afch/DDS-AD9910-Arduino-Shield/README.md

# DDS-AD9910-Arduino-Shield
DDS (Direct Digital Synthesis) Analog Devices AD9910 Arduino Shield by GRA &amp; AFCH

[HARDWARE Version 2.x:](https://github.com/afch/DDS-AD9910-Arduino-Shield/blob/master/README_HW2.md)  
[HARDWARE Version 3.x:](https://github.com/afch/DDS-AD9910-Arduino-Shield/blob/master/README_HW3.md)
