afch/DDS-AD9910-Arduino-Shield/Firmware Compiled (.HEX File)/HW2.x/Select Proper Arduino(Mega 2560).png

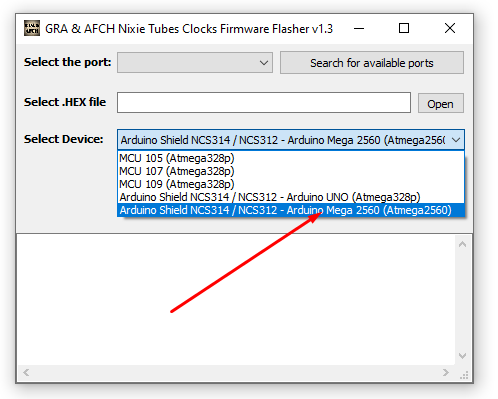
Firmware Compiled (.HEX File)/HW2.x/Select Proper Arduino(Mega 2560).png
