afch/DDS-AD9910-Arduino-Shield/Firmware Compiled (.HEX File)/HW2.x/Thank you Console Screenshot.png

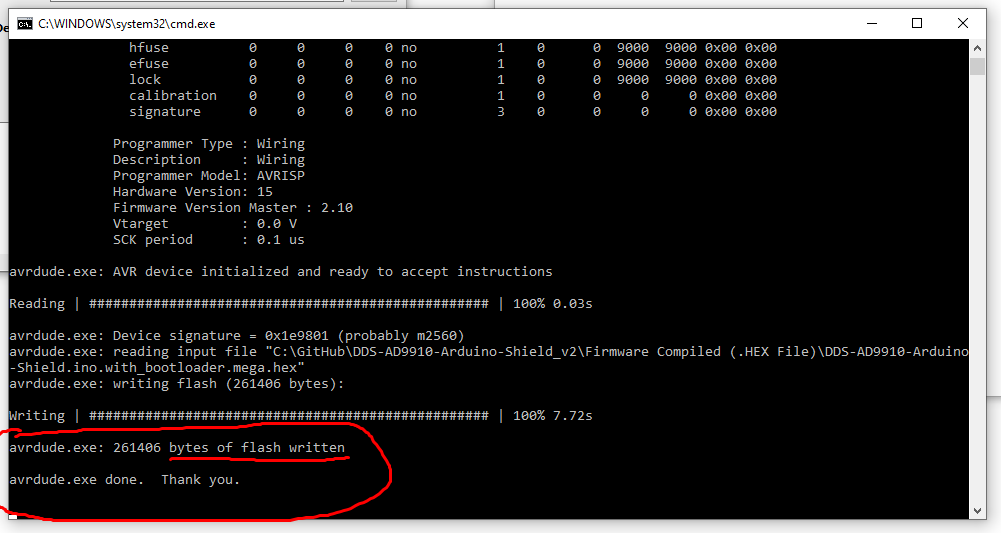
Firmware Compiled (.HEX File)/HW2.x/Thank you Console Screenshot.png
