afch/DDS-AD9910-Arduino-Shield/Firmware Source (.INO File)/HW3.x/DDS-AD9910-Arduino-Shield_HW3.x/ad9910.cpp

/****************************************************************************
 *   OFICIAL WEB-SITE:  https://gra-afch.com/product-category/rf-units/     *
 ****************************************************************************                                      
 *
 * AD9910 - DDS Power Supply 3.3V - 1.8V
 * Internal PLL up to 1.52 GHz, REF CLK Oscillator 5 - 60Mhz (PLL Enabled)
 * For More pure spectrum Recomendeted exteral oscillator 1 - 1.5 GHz
 * For signal without harmonics and the spur use an RF transformer  
 * ADT2-1T + LPF 7rd order Range: 0.4-450MHZ
 * ADT2-1T-1P + LPF 7rd order Range: 8-600MHZ
 * WBC2-1TLB + LPF 7rd order Range: 0.1(-4dB)-600MHZ(-7dB)
 * CX2147 + LPF 7rd order Range: 0.02(-3dB)-365(-3dB)/ or 0.01(-8dB)-480(-8dB)
 * Fout up 600 Mhz 
 * 17.06.2020
 * Author Grisha Anofriev e-mail: grisha.anofriev@gmail.com
******************************************************************************/

#include <Float64.h>
#define DEFAULT_STEP_VALUE 1000

#include "ad9910.h"
//#include "menuclk.h"
#include "main.h"

#include <math.h>
#include <float.h>
#include <Arduino.h>
int hspi1=0;

uint32_t DAC_Current;

uint8_t strBuffer[9];//={129, 165, 15, 255};

uint32_t FTW;
uint32_t *jlob;

extern uint32_t Ref_Clk;

void HAL_SPI_Transmit(int *blank, uint8_t *strBuffer, int nums, int pause)
{
  for (int i=0;i<nums; i++)
  {
    SPI.transfer(*(strBuffer+i));
  }
}

void HAL_Delay (int del)
{
  delayMicroseconds(del);
}
/******************************************************************************
 * HAL to Arduino
******************************************************************************/

void HAL_GPIO_WritePin (int port, int pin, int mode)
{
  digitalWrite(pin, mode);
}

/******************************************************************************
 * Init GPIO for DDS
******************************************************************************/
void DDS_GPIO_Init(void)
{
   pinMode(DDS_SPI_SCLK_PIN, OUTPUT);
   pinMode(DDS_SPI_SDIO_PIN, OUTPUT);
   pinMode(DDS_SPI_SDO_PIN, INPUT);
   pinMode(DDS_SPI_CS_PIN, OUTPUT);
   pinMode(DDS_IO_UPDATE_PIN, OUTPUT);
   pinMode(DDS_IO_RESET_PIN, OUTPUT);
   pinMode(DDS_MASTER_RESET_PIN, OUTPUT);
   pinMode(DDS_PROFILE_0_PIN, OUTPUT);
   pinMode(DDS_PROFILE_1_PIN, OUTPUT);
   pinMode(DDS_PROFILE_2_PIN, OUTPUT);
   pinMode(DDS_OSK_PIN, OUTPUT);
   pinMode(DDS_TxENABLE_PIN, OUTPUT);
   pinMode(DDS_F0_PIN, OUTPUT);
   pinMode(DDS_F1_PIN, OUTPUT);
   pinMode(DDS_DRHOLD_PIN, OUTPUT);
   pinMode(DDS_PWR_DWN_PIN, OUTPUT);
   pinMode(DDS_DRCTL_PIN, OUTPUT);
   
   pinMode(DDS_DROVER, INPUT);
   pinMode(DDS_SYNC_CLK, INPUT);
   pinMode(DDS_RAM_SWP_OVR, INPUT);
   pinMode(DDS_PLL_LOCK, INPUT);
   pinMode(DDS_PDCLK_PIN, INPUT);

  /*Configure GPIO pin Output Level */
  HAL_Delay(50);
  HAL_GPIO_WritePin(DDS_IO_UPDATE_GPIO_PORT, DDS_IO_UPDATE_PIN, GPIO_PIN_RESET);
  HAL_Delay(50);
	HAL_GPIO_WritePin(DDS_MASTER_RESET_GPIO_PORT, DDS_MASTER_RESET_PIN, GPIO_PIN_RESET);
  HAL_Delay(50);
	HAL_GPIO_WritePin(DDS_SPI_CS_GPIO_PORT, DDS_SPI_CS_PIN, GPIO_PIN_RESET);
  HAL_Delay(50);
	HAL_GPIO_WritePin(DDS_OSK_GPIO_PORT, DDS_OSK_PIN, GPIO_PIN_RESET);                     // OSK = 0
  HAL_Delay(50);
	HAL_GPIO_WritePin(DDS_PROFILE_0_GPIO_PORT, DDS_PROFILE_0_PIN, GPIO_PIN_RESET);
	HAL_GPIO_WritePin(DDS_PROFILE_1_GPIO_PORT, DDS_PROFILE_1_PIN, GPIO_PIN_RESET);
	HAL_GPIO_WritePin(DDS_PROFILE_2_GPIO_PORT, DDS_PROFILE_2_PIN, GPIO_PIN_RESET);

  HAL_GPIO_WritePin(DDS_PROFILE_2_GPIO_PORT, DDS_DRHOLD_PIN, GPIO_PIN_RESET);
  HAL_GPIO_WritePin(DDS_PROFILE_2_GPIO_PORT, DDS_DRCTL_PIN, GPIO_PIN_RESET);
  HAL_GPIO_WritePin(DDS_PROFILE_2_GPIO_PORT, DDS_PWR_DWN_PIN, GPIO_PIN_RESET);
  HAL_Delay(50);
}

/******************************************************************************
 * Init SPI, 8bit, Master
 * MODE 3, MSB, 
******************************************************************************/
void DDS_SPI_Init(void)
{
  SPI.begin(); //
  SPI.setDataMode (SPI_MODE0); 
  SPI.setClockDivider(SPI_CLOCK_DIV8); //16MHZ/8=2MHZ
  SPI.setBitOrder(MSBFIRST);
}


/*****************************************************************************************
   Update - data updates from memory
*****************************************************************************************/ 
void DDS_UPDATE(void)
{
	// Required - data updates from memory
   #if DBG==1
   Serial.println("***DDS_UPDATE****");
   #endif
	 HAL_Delay(10);
	 HAL_GPIO_WritePin(DDS_IO_UPDATE_GPIO_PORT, DDS_IO_UPDATE_PIN, GPIO_PIN_RESET); // IO_UPDATE = 0
	 HAL_Delay(10);
	 HAL_GPIO_WritePin(DDS_IO_UPDATE_GPIO_PORT, DDS_IO_UPDATE_PIN, GPIO_PIN_SET); // IO_UPDATE = 1
	 HAL_Delay(10);
	 HAL_GPIO_WritePin(DDS_IO_UPDATE_GPIO_PORT, DDS_IO_UPDATE_PIN, GPIO_PIN_RESET); // IO_UPDATE = 0
	 HAL_Delay(10);
}
 

/*****************************************************************************************
   F_OUT - Set Frequency in HZ 
   Num_Prof - Single Tone Mode 0..7
   Amplitude_dB - amplitude in dB from 0 to -84 (only negative values)
*****************************************************************************************/
void DDS_Fout (uint32_t *F_OUT, int16_t Amplitude_dB, uint8_t Num_Prof)
{
   uint32_t RealDDSCoreClock=CalcRealDDSCoreClockFromOffset();
   //FTW = ((uint32_t)(4294967296.0 *((float)*F_OUT / (float)DDS_Core_Clock)));
   //FTW = round(4294967296.0 *((float)*F_OUT / ((float)DDS_Core_Clock-ClockOffset))); // закомментировано 27.05.2020

   // значение FTW должно быть 4294967296 
    float64_t f64F_OUT=f64(*F_OUT);
    float64_t f64CoreClock=f64(RealDDSCoreClock);
    float64_t TwoPower32=f64(4294967295UL);
    float64_t f64FTW;
    //float64_t Offset=f64(ClockOffset);
    //CoreClock=f64_sub(CoreClock, Offset);
    f64FTW=f64_div(TwoPower32, f64CoreClock);
    f64FTW=f64_mul(f64FTW, f64F_OUT);
   //FTW = 4294967296 * (*F_OUT / (float)tmpCoreClock);
   bool a;
   uint_fast8_t softfloat_roundingMode;
   softfloat_roundingMode=softfloat_round_near_maxMag;
   FTW=f64_to_ui32(f64FTW, softfloat_roundingMode, a);
   jlob = & FTW;
   
   #if DBG==1
   Serial.print(F("*F_OUT="));
   Serial.println(*F_OUT); 
   Serial.print(F("DDS_Core_Clock="));
   Serial.println(DDS_Core_Clock); 
   Serial.print(F("FTW="));
   Serial.println(FTW); 
   #endif
   
   HAL_GPIO_WritePin(DDS_SPI_CS_GPIO_PORT, DDS_SPI_CS_PIN, GPIO_PIN_RESET); 	 
	 strBuffer[0] = Num_Prof; // Single_Tone_Profile_#;

   //ASF  - Amplitude 14bit 0...16127
	 strBuffer[1] =  (uint16_t)powf(10,(Amplitude_dB+84.288)/20.0) >> 8;     
	 strBuffer[2] =  (uint16_t)powf(10,(Amplitude_dB+84.288)/20.0);         
	 strBuffer[3] = 0x00;
	 strBuffer[4] = 0x00;

	 strBuffer[5] = *(((uint8_t*)jlob)+ 3);
	 strBuffer[6] = *(((uint8_t*)jlob)+ 2);
	 strBuffer[7] = *(((uint8_t*)jlob)+ 1);
	 strBuffer[8] = *(((uint8_t*)jlob));

   HAL_SPI_Transmit(&hspi1, (uint8_t*)strBuffer, 9, 1000);
	 HAL_GPIO_WritePin(DDS_SPI_CS_GPIO_PORT, DDS_SPI_CS_PIN, GPIO_PIN_SET);
	 
	 DDS_UPDATE(); 
  
   int Prof=Num_Prof;
   Prof=Prof-14; // address of 0 profile: 0x0E

   //Serial.print("Prof=");
   //Serial.println(Prof);
   
   if (bitRead(Prof, 0)==1) HAL_GPIO_WritePin(DDS_PROFILE_0_GPIO_PORT, DDS_PROFILE_0_PIN, GPIO_PIN_SET);
    else HAL_GPIO_WritePin(DDS_PROFILE_0_GPIO_PORT, DDS_PROFILE_0_PIN, GPIO_PIN_RESET);
   if (bitRead(Prof, 1)==1) HAL_GPIO_WritePin(DDS_PROFILE_1_GPIO_PORT, DDS_PROFILE_1_PIN, GPIO_PIN_SET);
    else HAL_GPIO_WritePin(DDS_PROFILE_1_GPIO_PORT, DDS_PROFILE_1_PIN, GPIO_PIN_RESET);
   if (bitRead(Prof, 2)==1) HAL_GPIO_WritePin(DDS_PROFILE_2_GPIO_PORT, DDS_PROFILE_2_PIN, GPIO_PIN_SET);
    else HAL_GPIO_WritePin(DDS_PROFILE_2_GPIO_PORT, DDS_PROFILE_2_PIN, GPIO_PIN_RESET);

   DDS_UPDATE(); 
   //while (1);
}	


/*****************************************************************************************
   PrepRegistersToSaveWaveForm - Setup control registers to load wave forms into DDS RAM only for AD9910
 * Step_Rate - the value of M for the register Step_Rate, for the desired sampling rate from RAM (based on uS)
*****************************************************************************************/
void PrepRegistersToSaveWaveForm (uint64_t Step_Rate, uint16_t Step)
{
  // Config RAM Playback ***  
  strBuffer[0] = RAM_Profile_0; // Address reg profile 0
  strBuffer[1] = 0x00; // open
  strBuffer[2] = highByte((uint16_t)Step_Rate);  // RAM address Step Rate [15:8]  0x03;
  strBuffer[3] = lowByte((uint16_t)Step_Rate); //0xFA;  // Step Rate [7:0] ///0x0F   0xE8;

  Step=Step-1;  //расчитваем последнюю ячейку памяти под хранение все сгенерированых данных (отнимаем 1 так как ядреса начитнаются с 0)
  Step=Step<<6; //значимые биты начинаются только с 6ой позиции (см датащит)
   
  strBuffer[4] = highByte(Step); //0xF9;  // End RAM address [9:2] bits in register 15:8 bit 0x1F 1024   (0xC0 + 0xF9) 0.....999 = 1000
  strBuffer[5] = lowByte(Step); //0xC0;  // End RAM address [1:0] bits in register 7:6 bit  0xC0 

  // Serial.print("highByte((uint16_t)Step_Rate)=");
  // Serial.println(highByte((uint16_t)Step_Rate));

  // Serial.print("lowByte((uint16_t)Step_Rate)=");
  // Serial.println(lowByte((uint16_t)Step_Rate));

  // Serial.print("highByte(Step)=");
  // Serial.println(highByte(Step));

  // Serial.print("lowByte(Step)=");
  // Serial.println(lowByte(Step));

   
  strBuffer[6] = 0x00;  // Start RAM address [9:2] bits in register 15:8 bit
  strBuffer[7] = 0x00;  // Start RAM address [1:0] bits in register 7:6 bit
    
  strBuffer[8] =  Continuous_recirculate; // b100 - Continuous recerculate   No_dwell_high |
     
  HAL_GPIO_WritePin(DDS_SPI_CS_GPIO_PORT, DDS_SPI_CS_PIN, GPIO_PIN_RESET);
  HAL_SPI_Transmit(&hspi1, (uint8_t*)strBuffer, 9, 1000);
  HAL_GPIO_WritePin(DDS_SPI_CS_GPIO_PORT, DDS_SPI_CS_PIN, GPIO_PIN_SET);
   
  DDS_UPDATE(); 
  
  //*** Select Profile 0 
  HAL_GPIO_WritePin(DDS_PROFILE_0_GPIO_PORT, DDS_PROFILE_0_PIN, GPIO_PIN_RESET);
  HAL_GPIO_WritePin(DDS_PROFILE_1_GPIO_PORT, DDS_PROFILE_1_PIN, GPIO_PIN_RESET);
  HAL_GPIO_WritePin(DDS_PROFILE_2_GPIO_PORT, DDS_PROFILE_2_PIN, GPIO_PIN_RESET);  
  
  DDS_UPDATE(); 
}

/************************************************************************************************************
 * Функция находит и взвращает такое значение STEP и StepRate при котором значение StepRate было бы целым числом, но при этом значение STEP не превысило бы значение 1000
 * входные параметры это: указатетль на переменную STEP, по адресу этого указателя будет возвращено новое значение STEP, 
 * указатетль на переменную StepRate, по адресу этого указателя будет возвращено новое значение StepRate, 
 * F_mod - частота модуляции
 ************************************************************************************************************/
void calcBestStepRate(uint16_t *Step, uint64_t *Step_Rate, uint32_t F_mod)
{
  double T_Step;
  double fStep_Rate;

  uint32_t RealDDSCoreClock=CalcRealDDSCoreClockFromOffset();
  
  T_Step = 1.0/(F_mod * *Step); // necessary time step
  fStep_Rate = (T_Step * (float)RealDDSCoreClock)/4; // the value of M for the register Step_Rate, for the desired sampling rate from RAM

  *Step_Rate=ceil(fStep_Rate);
 
  *Step=(1.0/((*Step_Rate*4)/(float)RealDDSCoreClock))/F_mod;
}

/*****************************************************************************************
   SaveAM_WavesToRAM - calculate and store AM waves to RAM
   Input data:
   * F_carrier - frequency carrier Hz
   * F_mod - amplitude modulations Hz, 10Hz Min, 100kHz Max
   * Depth - depth modulation      0-100%
   * Amplitude_dB - отрицательное значение амплитуды в dBm (кроме случая когда DAC Current = HI)
*****************************************************************************************/ 
void SaveAMWavesToRAM(uint32_t F_carrier, uint32_t F_mod, uint32_t AM_DEPH, int16_t Amplitude_dB)
{
  #if DBG==1
  Serial.println(F("****SaveAMWavesToRAM***"));
  Serial.print("F_carrier=");
  Serial.println(F_carrier);
  Serial.print("F_mod=");
  Serial.println(F_mod);
  Serial.print("AM_DEPH=");
  Serial.println(AM_DEPH);
  #endif
  
  #define TWO_POWER_32 4294967296.0 //2^32
  //#define MAX_AMPLITUDE_VALUE 16383

  uint16_t MaxAmplitudeValue=(uint16_t)powf(10,(Amplitude_dB+84.288)/20.0);
  
  uint64_t Step_Rate;
  uint16_t Step;
  uint16_t n;
  double Deg;
  double Rad;
  double Sin=0;
  double DegIncrement; //=360.0/Step;
  uint32_t Amplitude_AM=0;
  uint32_t FTW_AM=0;
  uint8_t aFTW_AM_8_bit[4];

  Step=DEFAULT_STEP_VALUE;
  Step_Rate=0;

  calcBestStepRate(&Step, &Step_Rate, F_mod);
  #if DBG==1
  Serial.print(F("Step Rate="));
  Serial.println((uint32_t)(Step_Rate));
  Serial.print(F("Step="));
  Serial.println((uint32_t)(Step));
  #endif
  
  PrepRegistersToSaveWaveForm(Step_Rate, Step);

  DegIncrement=360.0/Step;
    
  //*************************************************************************
  Deg = 0; // start set deg
  HAL_GPIO_WritePin(DDS_SPI_CS_GPIO_PORT, DDS_SPI_CS_PIN, GPIO_PIN_RESET);
  uint8_t MemAdr=RAM_Start_Word;
  HAL_SPI_Transmit(&hspi1, &MemAdr, 1, 1000);
  
  for (n = 0; n < Step; n++)
    {
     //Rad = Deg * 0.01745; // conversion from degrees to radians RAD=DEG*Pi/180
     Rad = Deg * PI/180.0; 
     Sin = sin(Rad); // Get Sinus
     Amplitude_AM = MaxAmplitudeValue - (((MaxAmplitudeValue * (1 + Sin)) / 2) * (AM_DEPH/100.0)); 
     #if DBG==1
     //Serial.print("Amplitude_AM=");
     Serial.println(Amplitude_AM);
     #endif
     FTW_AM = Amplitude_AM<<18;
     aFTW_AM_8_bit[0]=(FTW_AM>>24);
     aFTW_AM_8_bit[1]=(FTW_AM>>16);
     aFTW_AM_8_bit[2]=(FTW_AM>>8);
     aFTW_AM_8_bit[3]=FTW_AM;
     HAL_SPI_Transmit(&hspi1, aFTW_AM_8_bit, 4, 1000);  
     Deg = Deg + DegIncrement;
    }
    HAL_GPIO_WritePin(DDS_SPI_CS_GPIO_PORT, DDS_SPI_CS_PIN, GPIO_PIN_SET);
    DDS_UPDATE();

    PlaybackAMFromRAM(F_carrier);
}

/*****************************************
 * PlaybackAMFromRAM - проигрывает данные из RAM интерпретируя их как данные для AM (тоесть как частоты)
 * внутри функции должны устанавливаться регистры FTW (значение высчитвается по формуле из датащита), отвечающие за значение несущей частоту (мощнсть в dBm) 
 **********************************************/
void PlaybackAMFromRAM(uint32_t F_carrier)
{
  //********* Digital Ramp disable*******
  HAL_GPIO_WritePin(DDS_SPI_CS_GPIO_PORT, DDS_SPI_CS_PIN, GPIO_PIN_RESET);    
  strBuffer[0] = CFR2_addr;
  strBuffer[1] = Enable_amplitude_scale_from_single_tone_profiles;//1;//0x00;
  strBuffer[2] = 0;//SYNC_CLK_enable;// | Read_effective_FTW; // Digital Ramp disable
  strBuffer[3] = 0;//PDCLK_enable;
  strBuffer[4] = Sync_timing_validation_disable;// | Parallel_data_port_enable;
  HAL_SPI_Transmit(&hspi1, (uint8_t*)strBuffer, 5, 1000);
  HAL_GPIO_WritePin(DDS_SPI_CS_GPIO_PORT, DDS_SPI_CS_PIN, GPIO_PIN_SET);  
  DDS_UPDATE();
  
  //*** RAM Enable ***
   HAL_GPIO_WritePin(DDS_SPI_CS_GPIO_PORT, DDS_SPI_CS_PIN, GPIO_PIN_RESET);    
   strBuffer[0] = CFR1_addr;
   strBuffer[1] = RAM_Playback_Amplitude | RAM_enable;// | RAM_enable;//0x00; RAM_Playback_Amplitude;//
   strBuffer[2] = 0;//Continuous_Profile_0_1; //0;//0x80;//0x00;
   strBuffer[3] = 0;//OSK_enable;//Select_auto_OSK;//OSK_enable;// | Select_auto_OSK;//0x00;
   strBuffer[4] = SDIO_input_only ;
   HAL_SPI_Transmit(&hspi1, (uint8_t*)strBuffer, 5, 1000);
   HAL_GPIO_WritePin(DDS_SPI_CS_GPIO_PORT, DDS_SPI_CS_PIN, GPIO_PIN_SET);
   DDS_UPDATE();
   
   HAL_GPIO_WritePin(DDS_SPI_CS_GPIO_PORT, DDS_SPI_CS_PIN, GPIO_PIN_RESET);    
   strBuffer[0] = FTW_addr;

   //Set Output Frequency for AM modulation
   //uint32_t FTW_AM = round((float)TWO_POWER_32 * ((float)F_carrier / (float)DDS_Core_Clock)); 
   uint32_t RealDDSCoreClock=CalcRealDDSCoreClockFromOffset();
   float64_t f64F_carrier=f64(F_carrier);
   float64_t f64CoreClock=f64(RealDDSCoreClock);
   float64_t TwoPower32=f64(4294967295UL);
   float64_t f64FTW;
   f64FTW=f64_div(TwoPower32, f64CoreClock);
   f64FTW=f64_mul(f64FTW, f64F_carrier);
   bool a;
   uint_fast8_t softfloat_roundingMode;
   softfloat_roundingMode=softfloat_round_near_maxMag;
   uint32_t FTW_AM=f64_to_ui32(f64FTW, softfloat_roundingMode, a);
   
   #if DBG==1 
   Serial.print(F("FTW_AM="));
   Serial.println(FTW_AM);
   #endif
   
   strBuffer[1]=(FTW_AM>>24);
   strBuffer[2]=(FTW_AM>>16);
   strBuffer[3]=(FTW_AM>>8);
   strBuffer[4]=FTW_AM;

   //значение регистра высчитывается по формуле FTW = ((uint32_t)(4294967296.0 *(((double)*F_OUT / Ref_Clk))));
   HAL_SPI_Transmit(&hspi1, (uint8_t*)strBuffer, 5, 1000);
   HAL_GPIO_WritePin(DDS_SPI_CS_GPIO_PORT, DDS_SPI_CS_PIN, GPIO_PIN_SET);
   
   DDS_UPDATE();
}

/*****************************************************************************************
   SaveFM_WavesToRAM - calculate and store FM waves to RAM
   Input data:
   * F_carrier - frequency carrier Hz
   * F_mod - frequency modulations Hz
   * F_dev - frequency deviations Hz
*****************************************************************************************/  
void SaveFMWavesToRAM (uint32_t F_carrier, uint32_t F_mod, uint32_t F_dev)
{
  #define TWO_POWER_32 4294967296.0 //2^32
  
  uint64_t Step_Rate;
  uint16_t Step;
  uint16_t n;
  double Deg;
  double Rad;
  double Sin=0;
  double DegIncrement=0;
  uint32_t FREQ_FM=0;
  uint32_t FTW_FM=0;
  uint8_t FTW_FM_8_bit[4];

  Step=DEFAULT_STEP_VALUE;
  Step_Rate=0;

  calcBestStepRate(&Step, &Step_Rate, F_mod);
      
  PrepRegistersToSaveWaveForm(Step_Rate, Step);
  //*** RAM Disable ***
  HAL_GPIO_WritePin(DDS_SPI_CS_GPIO_PORT, DDS_SPI_CS_PIN, GPIO_PIN_RESET);    
  strBuffer[0] = CFR1_addr;
  strBuffer[1] = 0; // RAM Disable
  strBuffer[2] = 0;//Inverse_sinc_filter_enable;//0;//
  strBuffer[3] = 0;//OSK Disable
  strBuffer[4] = SDIO_input_only ;
  HAL_SPI_Transmit(&hspi1, (uint8_t*)strBuffer, 5, 1000);
  HAL_GPIO_WritePin(DDS_SPI_CS_GPIO_PORT, DDS_SPI_CS_PIN, GPIO_PIN_SET);  
  DDS_UPDATE();
  //********RAM Disable END**********

  DegIncrement=360.0/Step;
  //*************************************************************************
  
  Deg = 0; // start set deg
  HAL_GPIO_WritePin(DDS_SPI_CS_GPIO_PORT, DDS_SPI_CS_PIN, GPIO_PIN_RESET);
  uint8_t MemAdr=RAM_Start_Word;
  HAL_SPI_Transmit(&hspi1, &MemAdr, 1, 1000);

     uint32_t RealDDSCoreClock=CalcRealDDSCoreClockFromOffset();
   float64_t f64FREQ_FM;//=f64(FREQ_FM);
   float64_t f64CoreClock=f64(RealDDSCoreClock);
   float64_t TwoPower32=f64(4294967295UL);
   float64_t f64FTW;
   bool a;
   uint_fast8_t softfloat_roundingMode;
   softfloat_roundingMode=softfloat_round_near_maxMag;
  
  for (n = 0; n < Step; n++)
    {
     //Rad = Deg * 0.01745; // conversion from degrees to radians RAD=DEG*Pi/180
     Rad = Deg * PI/180.0;
     Sin = sin(Rad); // Get Sinus
     FREQ_FM = F_carrier + (F_dev * Sin);
     //FTW_FM = round((double)TWO_POWER_32 * ((double)FREQ_FM / (double)DDS_Core_Clock)); 
     
    f64FREQ_FM=f64(FREQ_FM);
   f64FTW=f64_div(TwoPower32, f64CoreClock);
   f64FTW=f64_mul(f64FTW, f64FREQ_FM);
   
   FTW_FM=f64_to_ui32(f64FTW, softfloat_roundingMode, a);
     
     FTW_FM_8_bit[0]=(FTW_FM>>24);
     FTW_FM_8_bit[1]=(FTW_FM>>16);
     FTW_FM_8_bit[2]=(FTW_FM>>8);
     FTW_FM_8_bit[3]=FTW_FM;
     HAL_SPI_Transmit(&hspi1, FTW_FM_8_bit, 4, 1000);  
     Deg = Deg + DegIncrement; 
    }
    HAL_GPIO_WritePin(DDS_SPI_CS_GPIO_PORT, DDS_SPI_CS_PIN, GPIO_PIN_SET);
    delay(100); //test
    DDS_UPDATE();
    Serial.println("FM wave saved to RAM...");
    delay(100); //test
    PlaybackFMFromRAM(A*-1);
}

/*************************************************
 * PlaybackFMFromRAM - проигрывает данные из RAM интерпретируя их как данные для FM (тоесть как частоты)
 * внутри функции должны устанавливаться регистры ASF (значение высчитвается по формуле из датащита), отвечающие за амплитуду (мощнсть в dBm) 
 * Amplitude_dB - должна передаваться как отрицательное число (за исключением когда активирована функция DAC Current - HI)
 **********************************************/
void PlaybackFMFromRAM(int16_t Amplitude_dB)
{
  //********* Digital Ramp disable*******
  HAL_GPIO_WritePin(DDS_SPI_CS_GPIO_PORT, DDS_SPI_CS_PIN, GPIO_PIN_RESET);    
  strBuffer[0] = CFR2_addr;
  strBuffer[1] = Enable_amplitude_scale_from_single_tone_profiles;//1;//0x00;
  strBuffer[2] = 0;//SYNC_CLK_enable;// | Read_effective_FTW; // Digital Ramp disable
  strBuffer[3] = 0;//PDCLK_enable;
  strBuffer[4] = Sync_timing_validation_disable;// | Parallel_data_port_enable;
  HAL_SPI_Transmit(&hspi1, (uint8_t*)strBuffer, 5, 1000);
  HAL_GPIO_WritePin(DDS_SPI_CS_GPIO_PORT, DDS_SPI_CS_PIN, GPIO_PIN_SET);  
  DDS_UPDATE();
  
  //*** RAM Enable ***
   HAL_GPIO_WritePin(DDS_SPI_CS_GPIO_PORT, DDS_SPI_CS_PIN, GPIO_PIN_RESET);    
   strBuffer[0] = CFR1_addr;
   strBuffer[1] = RAM_Playback_Frequency | RAM_enable;// | RAM_enable;//0x00; RAM_Playback_Amplitude;//
   strBuffer[2] = 0;//Continuous_Profile_0_1; //0;//0x80;//0x00;
   strBuffer[3] = OSK_enable;// | Select_auto_OSK;//0x00;
   strBuffer[4] = SDIO_input_only ;
   HAL_SPI_Transmit(&hspi1, (uint8_t*)strBuffer, 5, 1000);
   HAL_GPIO_WritePin(DDS_SPI_CS_GPIO_PORT, DDS_SPI_CS_PIN, GPIO_PIN_SET);
   
   DDS_UPDATE();

   uint16_t AmplitudeRegistersValue=(uint16_t)powf(10,(Amplitude_dB+84.288)/20.0);

   //AmplitudeRegistersValue=AmplitudeRegistersValue<<2;

   HAL_GPIO_WritePin(DDS_SPI_CS_GPIO_PORT, DDS_SPI_CS_PIN, GPIO_PIN_RESET);    
   strBuffer[0] = ASF_addr;
   strBuffer[1] = 0x00; 
   strBuffer[2] = 0x00; 
   strBuffer[3] = AmplitudeRegistersValue >> 6; //15:8
   AmplitudeRegistersValue = AmplitudeRegistersValue << 2;
   AmplitudeRegistersValue = AmplitudeRegistersValue & B11111100;
   strBuffer[4] = AmplitudeRegistersValue; //7:2
   
   HAL_SPI_Transmit(&hspi1, (uint8_t*)strBuffer, 5, 1000);
   HAL_GPIO_WritePin(DDS_SPI_CS_GPIO_PORT, DDS_SPI_CS_PIN, GPIO_PIN_SET);
    
   DDS_UPDATE();
}



/*****************************************************************************
  Initialization DDS
  * Config SPI, Reset DDS and ReConfig SPI
  * Enable/Disable internal PLL, mux, div, charge pump current, Set VCO
  
    Input Parametr:
  * PLL - 1 enable, if 0 disable
  * Divider - This input REF CLOCK divider by 2, if 1 - Divider by 2, if 0 - Divider OFF
  * 
  * Set Current Output - 0..255, 127 - Default equal to 0 dB 
  * (если выключено, то в функцию нужно передать (или записать в управляющий регистр) 127, а если включено, то 255, и если включено, то также нужно в главном меню к значению ДБ прибавлять +4 dBM)
*****************************************************************************/
void DDS_Init(bool PLL, bool Divider, uint32_t Ref_Clk)
 {
   #if DBG==1
   Serial.println(F("DDS_Init"));
   Serial.print(F("PLL="));
   Serial.println(PLL);
   Serial.print(F("Divider="));
   Serial.println(Divider);
   Serial.print(F("Ref_Clk="));
   Serial.println(Ref_Clk);
   Serial.print(F("DDS_Core_Clock="));
   Serial.println(DDS_Core_Clock);
   #endif
   
   DDS_GPIO_Init();
   
   // It is very important for DDS AD9910 to set the initial port states
   HAL_GPIO_WritePin(DDS_MASTER_RESET_GPIO_PORT, DDS_MASTER_RESET_PIN, GPIO_PIN_SET);   // RESET = 1
   HAL_Delay(10);
   HAL_GPIO_WritePin(DDS_MASTER_RESET_GPIO_PORT, DDS_MASTER_RESET_PIN, GPIO_PIN_RESET); // RESET = 0
   HAL_GPIO_WritePin(DDS_IO_UPDATE_GPIO_PORT, DDS_IO_UPDATE_PIN, GPIO_PIN_RESET);       // IO_UPDATE = 0   
   HAL_GPIO_WritePin(DDS_SPI_CS_GPIO_PORT, DDS_SPI_CS_PIN, GPIO_PIN_SET);               // CS = 1
   HAL_GPIO_WritePin(DDS_OSK_GPIO_PORT, DDS_OSK_PIN, GPIO_PIN_SET);                     // OSK = 1
   HAL_GPIO_WritePin(DDS_PROFILE_0_GPIO_PORT, DDS_PROFILE_0_PIN, GPIO_PIN_RESET);
   HAL_GPIO_WritePin(DDS_PROFILE_1_GPIO_PORT, DDS_PROFILE_1_PIN, GPIO_PIN_RESET);
   HAL_GPIO_WritePin(DDS_PROFILE_2_GPIO_PORT, DDS_PROFILE_2_PIN, GPIO_PIN_RESET);
   
   DDS_SPI_Init();
   
   HAL_GPIO_WritePin(DDS_SPI_CS_GPIO_PORT, DDS_SPI_CS_PIN, GPIO_PIN_RESET);    
   strBuffer[0] = CFR1_addr;
   strBuffer[1] = 0;// RAM_enable;//RAM_Playback_Amplitude;// | RAM_enable;//0x00; 
   strBuffer[2] = 0;//Inverse_sinc_filter_enable;//0; //Continuous_Profile_0_1; //0;//0x80;//0x00;
   strBuffer[3] = 0; //OSK_enable | Select_auto_OSK;//0x00;
   strBuffer[4] = SDIO_input_only ;
   HAL_SPI_Transmit(&hspi1, (uint8_t*)strBuffer, 5, 1000);
   HAL_GPIO_WritePin(DDS_SPI_CS_GPIO_PORT, DDS_SPI_CS_PIN, GPIO_PIN_SET);
   
   DDS_UPDATE();
   
   HAL_GPIO_WritePin(DDS_SPI_CS_GPIO_PORT, DDS_SPI_CS_PIN, GPIO_PIN_RESET);    
   strBuffer[0] = CFR2_addr;
   strBuffer[1] = Enable_amplitude_scale_from_single_tone_profiles;//1;//0x00;
   strBuffer[2] = 0;//SYNC_CLK_enable;// | Read_effective_FTW;
   strBuffer[3] = 0;//0x08;//PDCLK_enable;
   strBuffer[4] = Sync_timing_validation_disable;// | Parallel_data_port_enable;
   HAL_SPI_Transmit(&hspi1, (uint8_t*)strBuffer, 5, 1000);
   HAL_GPIO_WritePin(DDS_SPI_CS_GPIO_PORT, DDS_SPI_CS_PIN, GPIO_PIN_SET);
   
   DDS_UPDATE();

  switch (PLL)
  {
    case false:
      /******************* External Oscillator 60 - 1000Mhz (Overclock up to 1500Mhz) ***************/ 
      HAL_GPIO_WritePin(DDS_SPI_CS_GPIO_PORT, DDS_SPI_CS_PIN, GPIO_PIN_RESET);    
      strBuffer[0] = CFR3_addr;
      strBuffer[1] = 0;//DRV0_REFCLK_OUT_High_output_current;//
      strBuffer[2] = 0;
      if (Divider) strBuffer[3] = REFCLK_input_divider_ResetB;
        else strBuffer[3] = REFCLK_input_divider_ResetB | REFCLK_input_divider_bypass;
      strBuffer[4] = 0; // SYSCLK= REF_CLK * N
      HAL_SPI_Transmit(&hspi1, (uint8_t*)strBuffer, 5, 1000);
      HAL_GPIO_WritePin(DDS_SPI_CS_GPIO_PORT, DDS_SPI_CS_PIN, GPIO_PIN_SET);
      DDS_UPDATE();
      //**************************
    break;
    case true:
      /******************* External Oscillator TCXO 3.2 - 60 MHz ***********************************************/ 
      HAL_GPIO_WritePin(DDS_SPI_CS_GPIO_PORT, DDS_SPI_CS_PIN, GPIO_PIN_RESET);    
      strBuffer[0] = CFR3_addr;
      if (DDS_Core_Clock<=1000000000) strBuffer[1] = VCO5; // bilo VCO3
        else strBuffer[1] = VCO5;  // | DRV0_REFCLK_OUT_High_output_current;
      strBuffer[2] = Icp387uA;   // Icp212uA, Icp237uA, Icp262uA, Icp287uA, Icp312uA, Icp337uA, Icp363uA, Icp387uA 
      strBuffer[3] = REFCLK_input_divider_ResetB | PLL_enable; // REFCLK_input_divider_bypass; //
      //strBuffer[4]=((uint32_t)DDS_Core_Clock/Ref_Clk)*2; // multiplier for PLL
      strBuffer[4]=round((float)DDS_Core_Clock/(float)Ref_Clk)*2; // multiplier for PLL
      //strBuffer[4]=round(((float)DDS_Core_Clock-ClockOffset)/(float)Ref_Clk)*2; // multiplier for PLL
      #if DBG==1
      Serial.print(F("PLL Multiplier="));
      Serial.println(strBuffer[4]);
      #endif
      HAL_SPI_Transmit(&hspi1, (uint8_t*)strBuffer, 5, 1000);
      HAL_GPIO_WritePin(DDS_SPI_CS_GPIO_PORT, DDS_SPI_CS_PIN, GPIO_PIN_SET);
      DDS_UPDATE();
    /**********************/
    break;
  }
   
   HAL_GPIO_WritePin(DDS_SPI_CS_GPIO_PORT, DDS_SPI_CS_PIN, GPIO_PIN_RESET);    
   strBuffer[0] = FSC_addr;
   strBuffer[1] = 0;
   strBuffer[2] = 0;
   strBuffer[3] = 0;
   if (DACCurrentIndex==0) strBuffer[4] = 0x7F; //DAC current Normal
    else strBuffer[4] = 0xFF;// Max carrent 255 = 31mA //DAC current HI
   HAL_SPI_Transmit(&hspi1, (uint8_t*)strBuffer, 5, 1000);
   HAL_GPIO_WritePin(DDS_SPI_CS_GPIO_PORT, DDS_SPI_CS_PIN, GPIO_PIN_SET);
   
   DDS_UPDATE();
   
   /*HAL_GPIO_WritePin(DDS_SPI_CS_GPIO_PORT, DDS_SPI_CS_PIN, GPIO_PIN_RESET);    
   strBuffer[0] = 0x0E; //profile 0 address
   strBuffer[1] = 0x3F;
   strBuffer[2] = 0xFF;
   strBuffer[3] = 0x00;
   strBuffer[4] = 0x00;
   
   strBuffer[5] = 0x19;
   strBuffer[6] = 0x99;
   strBuffer[7] = 0x9A;
   strBuffer[8] = 0x6C; // 100mhz
   HAL_SPI_Transmit(&hspi1, (uint8_t*)strBuffer, 9, 1000);
   HAL_GPIO_WritePin(DDS_SPI_CS_GPIO_PORT, DDS_SPI_CS_PIN, GPIO_PIN_SET);
   
   DDS_UPDATE(); 
   //while (1);*/
}                

/*************************************************************************
 * Freq Out, freq_output in Hz 0 HZ - 450MHZ, 
 * amplitude_dB_output - from 0 to -84 (negative)
 ************************************************************************/
void SingleProfileFreqOut(uint32_t freq_output, int16_t amplitude_dB_output) 
{
  #if DBG==1
  Serial.println(F("****SingleProfileFreqOut***"));
  Serial.print(F("freq_output="));
  Serial.println(freq_output);
  Serial.print(F("amplitude_dB_output="));
  Serial.println(amplitude_dB_output);
  #endif
  //*** RAM Disable ***
  HAL_GPIO_WritePin(DDS_SPI_CS_GPIO_PORT, DDS_SPI_CS_PIN, GPIO_PIN_RESET);    
  strBuffer[0] = CFR1_addr;
  strBuffer[1] = 0; // RAM Disable
  strBuffer[2] = 0;//Inverse_sinc_filter_enable;//0;//
  strBuffer[3] = 0;//OSK Disable
  strBuffer[4] = SDIO_input_only ;
  HAL_SPI_Transmit(&hspi1, (uint8_t*)strBuffer, 5, 1000);
  HAL_GPIO_WritePin(DDS_SPI_CS_GPIO_PORT, DDS_SPI_CS_PIN, GPIO_PIN_SET);  
  DDS_UPDATE();
  
  //********* Digital Ramp disable*******
  HAL_GPIO_WritePin(DDS_SPI_CS_GPIO_PORT, DDS_SPI_CS_PIN, GPIO_PIN_RESET);    
  strBuffer[0] = CFR2_addr;
  strBuffer[1] = Enable_amplitude_scale_from_single_tone_profiles;//1;//0x00;
  strBuffer[2] = 0;//SYNC_CLK_enable;// | Read_effective_FTW; // Digital Ramp disable
  strBuffer[3] = 0;//PDCLK_enable;
  strBuffer[4] = Sync_timing_validation_disable;// | Parallel_data_port_enable;
  HAL_SPI_Transmit(&hspi1, (uint8_t*)strBuffer, 5, 1000);
  HAL_GPIO_WritePin(DDS_SPI_CS_GPIO_PORT, DDS_SPI_CS_PIN, GPIO_PIN_SET);  
  DDS_UPDATE();
  
  DDS_Fout(&freq_output, amplitude_dB_output, Single_Tone_Profile_0);
 
  /*HAL_GPIO_WritePin(DDS_PROFILE_0_GPIO_PORT, DDS_PROFILE_0_PIN, GPIO_PIN_SET);
  HAL_GPIO_WritePin(DDS_PROFILE_1_GPIO_PORT, DDS_PROFILE_1_PIN, GPIO_PIN_RESET);
  HAL_GPIO_WritePin(DDS_PROFILE_2_GPIO_PORT, DDS_PROFILE_2_PIN, GPIO_PIN_SET);*/
}


/**************
 * Return Real Core Clock based on ClockOffset 
 */
uint32_t CalcRealDDSCoreClockFromOffset()
{
  int N=DDS_Core_Clock/Ref_Clk;
  uint32_t RCC = (Ref_Clk+ClockOffset)*N;
  #if DBG==1
  Serial.print("DDS_Core_Clock=");
  Serial.println(DDS_Core_Clock);
  Serial.print("Ref_Clk=");
  Serial.println(Ref_Clk);
  Serial.print("N=");
  Serial.println(N); 
  Serial.print("RCC=");
  Serial.println(RCC);
  #endif
  return RCC;
}

/*
void SaveDTMFToRAM (uint32_t Tone1, uint32_t Tone2, uint32_t F_dev) //do not use
{
  //#define TWO_POWER_32 4294967296.0 //2^32

  //Tone1=100001000;
  Tone1=100001000;
  Tone2=100003000;
  //F_mod=10000;
  
  uint64_t Step_Rate;
  uint16_t Step;
  uint32_t FTW_FM=0;
  uint8_t FTW_FM_8_bit[4];

  Step=2;
  Step_Rate=65535;

  //calcBestStepRate(&Step, &Step_Rate, 10000);
  Serial.println("******SSB DTMF***");
  Serial.print("Step=");
  Serial.println(Step);

  Serial.print("Step_Rate=");
  Serial.println((uint32_t)Step_Rate);

  PrepRegistersToSaveWaveForm(Step_Rate, Step);

  HAL_GPIO_WritePin(DDS_SPI_CS_GPIO_PORT, DDS_SPI_CS_PIN, GPIO_PIN_RESET);
  uint8_t MemAdr=RAM_Start_Word;
  HAL_SPI_Transmit(&hspi1, &MemAdr, 1, 1000);

    uint32_t RealDDSCoreClock=CalcRealDDSCoreClockFromOffset();
   float64_t f64Tone1;//=f64(FREQ_FM);
   float64_t f64Tone2;
   float64_t f64CoreClock=f64(RealDDSCoreClock);
   float64_t TwoPower32=f64(4294967295UL);
   float64_t f64FTW;
   bool a;
   uint_fast8_t softfloat_roundingMode;
   softfloat_roundingMode=softfloat_round_near_maxMag;
  
       
   f64Tone1=f64(Tone1);
   f64FTW=f64_div(TwoPower32, f64CoreClock);
   f64FTW=f64_mul(f64FTW, f64Tone1);
   
   FTW_FM=f64_to_ui32(f64FTW, softfloat_roundingMode, a);

   Serial.print("FTW for tone 1=");
   Serial.println(FTW_FM);
     
     FTW_FM_8_bit[0]=(FTW_FM>>24);
     FTW_FM_8_bit[1]=(FTW_FM>>16);
     FTW_FM_8_bit[2]=(FTW_FM>>8);
     FTW_FM_8_bit[3]=FTW_FM;
     HAL_SPI_Transmit(&hspi1, FTW_FM_8_bit, 4, 1000);  

   f64Tone2=f64(Tone2);
   f64FTW=f64_div(TwoPower32, f64CoreClock);
   f64FTW=f64_mul(f64FTW, f64Tone2);
   
   FTW_FM=f64_to_ui32(f64FTW, softfloat_roundingMode, a);
   Serial.print("FTW for tone 2=");
   Serial.println(FTW_FM);
     
     FTW_FM_8_bit[0]=(FTW_FM>>24);
     FTW_FM_8_bit[1]=(FTW_FM>>16);
     FTW_FM_8_bit[2]=(FTW_FM>>8);
     FTW_FM_8_bit[3]=FTW_FM;
     HAL_SPI_Transmit(&hspi1, FTW_FM_8_bit, 4, 1000); 

    HAL_GPIO_WritePin(DDS_SPI_CS_GPIO_PORT, DDS_SPI_CS_PIN, GPIO_PIN_SET);
    DDS_UPDATE();
    
     Serial.println("FM wave saved to RAM...");
    PlaybackFMFromRAM(A*-1);
}*/

/*
void SingleProfileSSBDTMF(uint32_t freq_output, int16_t amplitude_dB_output) //do not use!!!
{
  #if DBG==1
  Serial.println(F("****SingleProfileFreqOut***"));
  Serial.print(F("freq_output="));
  Serial.println(freq_output);
  Serial.print(F("amplitude_dB_output="));
  Serial.println(amplitude_dB_output);
  #endif
  //*** RAM Disable ***
  HAL_GPIO_WritePin(DDS_SPI_CS_GPIO_PORT, DDS_SPI_CS_PIN, GPIO_PIN_RESET);    
  strBuffer[0] = CFR1_addr;
  strBuffer[1] = 0; // RAM Disable
  strBuffer[2] = 0;//
  strBuffer[3] = 0;//OSK Disable
  strBuffer[4] = SDIO_input_only ;
  HAL_SPI_Transmit(&hspi1, (uint8_t*)strBuffer, 5, 1000);
  HAL_GPIO_WritePin(DDS_SPI_CS_GPIO_PORT, DDS_SPI_CS_PIN, GPIO_PIN_SET);  
  DDS_UPDATE();

  freq_output=100001000;
  DDS_Fout(&freq_output, amplitude_dB_output, Single_Tone_Profile_0);
  freq_output=100003000;
  DDS_Fout(&freq_output, amplitude_dB_output, Single_Tone_Profile_1);

  while (1)
  {
    HAL_GPIO_WritePin(DDS_PROFILE_0_GPIO_PORT, DDS_PROFILE_0_PIN, GPIO_PIN_RESET);
    //HAL_GPIO_WritePin(DDS_PROFILE_1_GPIO_PORT, DDS_PROFILE_1_PIN, GPIO_PIN_RESET);
    //HAL_GPIO_WritePin(DDS_PROFILE_2_GPIO_PORT, DDS_PROFILE_2_PIN, GPIO_PIN_RESET);
    delay(100);
    HAL_GPIO_WritePin(DDS_PROFILE_0_GPIO_PORT, DDS_PROFILE_0_PIN, GPIO_PIN_SET);
    //HAL_GPIO_WritePin(DDS_PROFILE_1_GPIO_PORT, DDS_PROFILE_1_PIN, GPIO_PIN_RESET);
    //HAL_GPIO_WritePin(DDS_PROFILE_2_GPIO_PORT, DDS_PROFILE_2_PIN, GPIO_PIN_RESET);
    delay(100);
  }
}
*/

/*************************************************************************************
 * Digital Ramp Generator Enable
 **********************************************************************************/
void DigitalRamp(uint32_t FTWStart, uint32_t FTWEnd, uint32_t FTWStepSize, uint16_t StepRate, bool continuous)
{

  int Amplitude_dB=0;
   HAL_GPIO_WritePin(DDS_SPI_CS_GPIO_PORT, DDS_SPI_CS_PIN, GPIO_PIN_RESET);   
   strBuffer[0] = Single_Tone_Profile_0; //Num_Prof; // Single_Tone_Profile_#;

   //ASF  - Amplitude 14bit 0...16127
   strBuffer[1] =  (uint16_t)powf(10,(Amplitude_dB+84.288)/20.0) >> 8;     
   strBuffer[2] =  (uint16_t)powf(10,(Amplitude_dB+84.288)/20.0);       
             
   strBuffer[3] = 0; //0xFF;
   strBuffer[4] = 0; //0xFF;
   
   strBuffer[5] = 0; //0xFF;
   strBuffer[6] = 0; //0xFF;
   strBuffer[7] = 0; //0xFF;
   strBuffer[8] = 0; //0xFF;

   HAL_SPI_Transmit(&hspi1, (uint8_t*)strBuffer, 9, 1000);
   HAL_GPIO_WritePin(DDS_SPI_CS_GPIO_PORT, DDS_SPI_CS_PIN, GPIO_PIN_SET);
   DDS_UPDATE(); 

    HAL_GPIO_WritePin(DDS_PROFILE_0_GPIO_PORT, DDS_PROFILE_0_PIN, GPIO_PIN_RESET);
    HAL_GPIO_WritePin(DDS_PROFILE_1_GPIO_PORT, DDS_PROFILE_1_PIN, GPIO_PIN_RESET);
    HAL_GPIO_WritePin(DDS_PROFILE_2_GPIO_PORT, DDS_PROFILE_2_PIN, GPIO_PIN_RESET);
   
////
  
  //*** RAM Disable
  HAL_GPIO_WritePin(DDS_SPI_CS_GPIO_PORT, DDS_SPI_CS_PIN, GPIO_PIN_RESET);    
  strBuffer[0] = CFR1_addr;
  strBuffer[1] = 0;// RAM_enable; 
  strBuffer[2] = 0; 
  strBuffer[3] = Autoclear_digital_ramp_accumulator;// БЫЛО 0//OSK Disable // Autoclear_digital_ramp_accumulator (нужен чтобы програмно можно был перезапустить DRG c начала);
  strBuffer[4] = SDIO_input_only ;
  HAL_SPI_Transmit(&hspi1, (uint8_t*)strBuffer, 5, 1000);
  HAL_GPIO_WritePin(DDS_SPI_CS_GPIO_PORT, DDS_SPI_CS_PIN, GPIO_PIN_SET);  
  DDS_UPDATE();


//*** digital Ramp LIMITS enable
  HAL_GPIO_WritePin(DDS_SPI_CS_GPIO_PORT, DDS_SPI_CS_PIN, GPIO_PIN_RESET);    
  strBuffer[0] = Digital_Ramp_Limit;
  
  strBuffer[1] = FTWEnd>>24; // upper limit
  strBuffer[2] = FTWEnd>>16; // upper limit
  strBuffer[3] = FTWEnd>>8;  // upper limit
  strBuffer[4] = FTWEnd;     // upper limit
  
  strBuffer[5] = FTWStart>>24; // lower limit
  strBuffer[6] = FTWStart>>16; // lower limit
  strBuffer[7] = FTWStart>>8;  // lower limit
  strBuffer[8] = FTWStart;     // lower limit
  
  HAL_SPI_Transmit(&hspi1, (uint8_t*)strBuffer, 9, 1000);
  HAL_GPIO_WritePin(DDS_SPI_CS_GPIO_PORT, DDS_SPI_CS_PIN, GPIO_PIN_SET);  
  DDS_UPDATE();

  //*** digital  Ramp Step Size enable
  HAL_GPIO_WritePin(DDS_SPI_CS_GPIO_PORT, DDS_SPI_CS_PIN, GPIO_PIN_RESET);    
  strBuffer[0] = Digital_Ramp_Step_Size;
  
  //**** Dicrement ****
  strBuffer[1] = FTWStepSize>>24; 
  strBuffer[2] = FTWStepSize>>16;  
  strBuffer[3] = FTWStepSize>>8; 
  strBuffer[4] = FTWStepSize; 

   //**** Increment ****
  strBuffer[5] = FTWStepSize>>24; 
  strBuffer[6] = FTWStepSize>>16;
  strBuffer[7] = FTWStepSize>>8;
  strBuffer[8] = FTWStepSize; 
  
  HAL_SPI_Transmit(&hspi1, (uint8_t*)strBuffer, 9, 1000);
  HAL_GPIO_WritePin(DDS_SPI_CS_GPIO_PORT, DDS_SPI_CS_PIN, GPIO_PIN_SET);  
  DDS_UPDATE();

  //*** digital  Ramp Step Rate enable
  HAL_GPIO_WritePin(DDS_SPI_CS_GPIO_PORT, DDS_SPI_CS_PIN, GPIO_PIN_RESET);    
  strBuffer[0] = Digital_Ramp_Rate;
  
  strBuffer[1] = StepRate>>8; // Negative Slope Rate
  strBuffer[2] = StepRate; // Negative Slope Rate
  strBuffer[3] = StepRate>>8; // Positive Slope Rate
  strBuffer[4] = StepRate; // Positive Slope Rate
  
  HAL_SPI_Transmit(&hspi1, (uint8_t*)strBuffer, 5, 1000);
  HAL_GPIO_WritePin(DDS_SPI_CS_GPIO_PORT, DDS_SPI_CS_PIN, GPIO_PIN_SET);  
  DDS_UPDATE();

  ////////////////////// TOGLE TRG_OUT
  //delay(10);
  //digitalWrite(TRG_OUT_PIN, HIGH);
  //PORTL |= (1 << PORTL1);

//   delayMicroseconds(10);
//   PORTL &= ~(1 << PORTL1);
// #if DBG==1
//   Serial.println(F("TRG_OUT: LOW"));
//  #endif
  ////////////////////
  
 //*** digital Ramp Generator enable
  HAL_GPIO_WritePin(DDS_SPI_CS_GPIO_PORT, DDS_SPI_CS_PIN, GPIO_PIN_RESET);    
  strBuffer[0] = CFR2_addr;
  strBuffer[1] = 0; 
  if (continuous == true) strBuffer[2] = Digital_Ramp_Destination_Frequency | Digital_ramp_enable | Digital_ramp_no_dwell_high | Digital_ramp_no_dwell_low; // Digital_ramp_no_dwell_high - не останавливатся вверху, Digital_ramp_no_dwell_low - не остановливатся внизу
    else strBuffer[2] =                  Digital_Ramp_Destination_Frequency | Digital_ramp_enable;// | Digital_ramp_no_dwell_high | Digital_ramp_no_dwell_low;  // Digital_ramp_no_dwell_high - не останавливатся вверху, Digital_ramp_no_dwell_low - не остановливатся внизу
  strBuffer[3] = 0;//
  strBuffer[4] = 0;// ;
  HAL_SPI_Transmit(&hspi1, (uint8_t*)strBuffer, 5, 1000);
  HAL_GPIO_WritePin(DDS_SPI_CS_GPIO_PORT, DDS_SPI_CS_PIN, GPIO_PIN_SET);  
  pinMode(DDS_DRCTL_PIN, OUTPUT); //????????
  digitalWrite(DDS_DRCTL_PIN, HIGH); //??????
  DDS_UPDATE();
  #if DBG==1
  Serial.print("CFR2=");
  Serial.println(strBuffer[2]);
  Serial.println("End of Digital Ramp Function");
  #endif

  //delayMicroseconds(10);
 // delay(50);
  // PORTL &= ~(1 << PORTL1);
}


//SweepTimeFormat: 0 - Seconds, 1 - Milliseconds (mS), 2 - MicroSeconds (uS), 3 - NanoSeconds
void Sweep(uint32_t StartSweepFreq, uint32_t StopSweepFreq, uint16_t SweepTime, uint8_t SweepTimeFormat, bool continuous)
{
  #if DBG==1
  Serial.print("StartSweepFreq=");
  Serial.println(StartSweepFreq);
  Serial.print("StopSweepFreq=");
  Serial.println(StopSweepFreq);
  Serial.print("SweepTime=");
  Serial.println(SweepTime);
  Serial.print("SweepTimeFormat=");
  Serial.println(SweepTimeFormat);
  #endif
  //float64_t NanoSweepTime=f64((uint32_t)SweepTime); //F64_div, f64_mul
  uint64_t NanoSweepTime;
  uint64_t CaluclatedNanoSweepTime;
  uint32_t FTWStart=FreqToFTW(StartSweepFreq);
  uint32_t FTWEnd=FreqToFTW(StopSweepFreq);
  uint32_t DeltaFTW=FTWEnd-FTWStart;
  uint32_t FTWStepSize=1;
  uint16_t StepRate=1;
  
  if (SweepTimeFormat==0) NanoSweepTime=SweepTime*1E9;
    else if (SweepTimeFormat==1) NanoSweepTime=SweepTime*1E6;
      else if (SweepTimeFormat==2) NanoSweepTime=SweepTime*1E3;
      
  float GHZ_CoreClock=DDS_Core_Clock/1E9; //незабыть заменит на realDDSCoreClock
  CaluclatedNanoSweepTime=(4/GHZ_CoreClock*DeltaFTW*FTWStepSize);
  
  if (CaluclatedNanoSweepTime<NanoSweepTime) 
  {
    uint32_t StepRateMultiplier=round(NanoSweepTime/float(CaluclatedNanoSweepTime));
    if (StepRateMultiplier<=0xFFFF) StepRate=StepRate*StepRateMultiplier;
      else StepRate=0xFFFF;
  }
  #if DBG==1
  Serial.print("StepRate=");
  Serial.println((uint32_t)StepRate);
  #endif
  if (CaluclatedNanoSweepTime>NanoSweepTime)
  {
    uint32_t FTWMultiplier=round(CaluclatedNanoSweepTime/float(NanoSweepTime));
    FTWStepSize=FTWStepSize*FTWMultiplier;
  }
  #if DBG==1
  Serial.print("FTWStepSize=");
  Serial.println((uint32_t)FTWStepSize);
  #endif
  DigitalRamp(FTWStart, FTWEnd, FTWStepSize, StepRate, continuous);
}

uint32_t FreqToFTW(uint32_t Freq)
{
    uint32_t RealDDSCoreClock=CalcRealDDSCoreClockFromOffset();
    bool a;
    
    float64_t f64Freq=f64(Freq);
    float64_t f64CoreClock=f64(RealDDSCoreClock);
    float64_t TwoPower32=f64(4294967295UL);
    float64_t f64FTW;
    
    f64FTW=f64_div(TwoPower32, f64CoreClock);
    f64FTW=f64_mul(f64FTW, f64Freq);
   
    uint_fast8_t softfloat_roundingMode;
    softfloat_roundingMode=softfloat_round_near_maxMag;
    return f64_to_ui32(f64FTW, softfloat_roundingMode, a);
}

void RestartDRG()
{
//*** RAM Disable
  // HAL_GPIO_WritePin(DDS_SPI_CS_GPIO_PORT, DDS_SPI_CS_PIN, GPIO_PIN_RESET);    
  // strBuffer[0] = CFR1_addr;
  // strBuffer[1] = 0;// RAM_enable; 
  // strBuffer[2] = 0; 
  // strBuffer[3] = Autoclear_digital_ramp_accumulator | Clear_digital_ramp_accumulator;// БЫЛО 0//OSK Disable // Autoclear_digital_ramp_accumulator (нужен чтобы програмно можно был перезапустить DRG c начала);
  // strBuffer[4] = SDIO_input_only ;
  // HAL_SPI_Transmit(&hspi1, (uint8_t*)strBuffer, 5, 1000);
  // HAL_GPIO_WritePin(DDS_SPI_CS_GPIO_PORT, DDS_SPI_CS_PIN, GPIO_PIN_SET);  
  // DDS_UPDATE();

  //  HAL_Delay(10);
	//  HAL_GPIO_WritePin(DDS_IO_UPDATE_GPIO_PORT, DDS_IO_UPDATE_PIN, GPIO_PIN_RESET); // IO_UPDATE = 0
	//  HAL_Delay(10);
	//  HAL_GPIO_WritePin(DDS_IO_UPDATE_GPIO_PORT, DDS_IO_UPDATE_PIN, GPIO_PIN_SET); // IO_UPDATE = 1
	//  HAL_Delay(10);
	//  HAL_GPIO_WritePin(DDS_IO_UPDATE_GPIO_PORT, DDS_IO_UPDATE_PIN, GPIO_PIN_RESET); // IO_UPDATE = 0
	 //HAL_Delay(10);
  //Serial.println("Restart DRG");
  // HAL_GPIO_WritePin(DDS_SPI_CS_GPIO_PORT, DDS_SPI_CS_PIN, GPIO_PIN_RESET);    
  // strBuffer[0] = CFR1_addr;
  // strBuffer[1] = 0;// RAM_enable; 
  // strBuffer[2] = 0; 
  // strBuffer[3] = 0; // Autoclear_digital_ramp_accumulator (нужен чтобы програмно можно был перезапустить DRG c начала);
  // strBuffer[4] = SDIO_input_only ;
  // HAL_SPI_Transmit(&hspi1, (uint8_t*)strBuffer, 5, 1000);
  // HAL_GPIO_WritePin(DDS_SPI_CS_GPIO_PORT, DDS_SPI_CS_PIN, GPIO_PIN_SET);  
  // DDS_UPDATE();
  HAL_GPIO_WritePin(DDS_SPI_CS_GPIO_PORT, DDS_SPI_CS_PIN, GPIO_PIN_RESET);    
  strBuffer[0] = CFR2_addr;
  strBuffer[1] = 0; 
  strBuffer[2] = Digital_Ramp_Destination_Frequency | Digital_ramp_enable;// | Digital_ramp_no_dwell_high | Digital_ramp_no_dwell_low;  // Digital_ramp_no_dwell_high - не останавливатся вверху, Digital_ramp_no_dwell_low - не остановливатся внизу
  strBuffer[3] = 0;//
  strBuffer[4] = 0;// ;
  HAL_SPI_Transmit(&hspi1, (uint8_t*)strBuffer, 5, 1000);
  HAL_GPIO_WritePin(DDS_SPI_CS_GPIO_PORT, DDS_SPI_CS_PIN, GPIO_PIN_SET);  
  
  //pinMode(DDS_DRCTL_PIN, OUTPUT); //????????
  //digitalWrite(DDS_DRCTL_PIN, HIGH); //??????

  //DDS_UPDATE();

  HAL_GPIO_WritePin(DDS_IO_UPDATE_GPIO_PORT, DDS_IO_UPDATE_PIN, GPIO_PIN_RESET); // IO_UPDATE = 0
	//  HAL_Delay(10);
	HAL_GPIO_WritePin(DDS_IO_UPDATE_GPIO_PORT, DDS_IO_UPDATE_PIN, GPIO_PIN_SET); // IO_UPDATE = 1
	//  HAL_Delay(10);
	HAL_GPIO_WritePin(DDS_IO_UPDATE_GPIO_PORT, DDS_IO_UPDATE_PIN, GPIO_PIN_RESET); // IO_UPDATE = 0
}
