afch/DDS-AD9910-Arduino-Shield/(commit log)

2023-03-29 USB drivers
2024-02-26 Drivers update
2024-10-29 v2.20
    Improved stability upon startup
    [DDS-AD9910-Arduino-Shield.ino, ad9910.cpp]
2025-02-10 v.3.19 Low and High Limits bug fix
    [DDS-AD9910-Arduino-Shield_HW3.x.ino]
2025-04-11 v.3.20
    Bug fix: Settings modified while the output was off were not applied.
    [DDS-AD9910-Arduino-Shield_HW3.x.ino, ReadSerialCommands.ino]
2026-09-22 v.3.22
    Amplitude modification is separated from other parameter changes for FM modulation (applicable to both encoder and serial port commands).
    Two 100 ms delays have been added after writing FM data to RAM.
    `RAM_Enable = 0` has been added before writing new values.
